piposa/YUDX-tool-changer/README.md

# YUDX-tool-changer
An open source tool changing program for 3D printing.
discord:https://discord.gg/vE4ExaVR3
