piposa/YUDX-tool-changer/“YUDX”BOM.xlsx

 | Info: 1. The finished YUDX extruder kit may be released in the coming months. You may wait for its launch. 2. Amazon links were found by Claude Code. Links may be incorrect, please feedback any errors to me. 3. discord:https://discord.gg/vE4ExaVR3 4. https://github.com/dumplinglab/YUDX-tool-changer
number | Notes | Part Name (corresponds to STEP file) | Qty | Type | Amazon Product | Price | Amazon Link
1 | VORON existing part | MGN12H_block | 1 | Standard Part | MGN12H 300mm Premium Linear Guide Rail 2 Pcs MGN12 Linear Slide 8mm for 3D Printer CNC (2 Pcs/Pack) | $26.92 | https://www.amazon.com/dp/B09ZPHPB5F
2 | VORON existing part | MGN12 | 1 | Standard Part | MGN12H 300mm Premium Linear Guide Rail 2 Pcs MGN12 Linear Slide 8mm for 3D Printer CNC (2 Pcs/Pack) | $26.92 | https://www.amazon.com/dp/B09ZPHPB5F
3 | VORON existing part | Aluminum profiles | 1 | Standard Part |  | $0
4 | Extruder kit | outer_shell_of_extruder | 1 | 3D Printed Part |  | $0
5 | Extruder kit | gear_container_plastic_part | 2 | 3D Printed Part |  | $0
6 | Extruder kit | rack_below_part | 1 | 3D Printed Part |  | $0
7 | Extruder kit | double_layer_gear | 2 | Custom Gear |  | $35
8 | Extruder kit | extrude_gear | 2 | Custom Gear |  | $19.40
9 | Extruder kit | 0.5m10gear | 2 | Custom Gear |  | $32
10 | Extruder kit | gear_container_metal_part | 2 | Custom CNC Part |  | $18.8
11 | Extruder kit | axle_for_extrude_gear | 2 | Custom CNC Part |  | $23
12 | Extruder kit | gear_container_metal_part_mirror | 2 | Custom CNC Part |  | $18.8
13 | Extruder kit | extruder_bottom_metal_part | 1 | Custom CNC Part |  | $9.9
14 | Extruder kit | extruder_top_metal_part | 1 | Custom CNC Part |  | $9.9
15 | Extruder kit | extruder_top_metal_part_mirror | 1 | Custom CNC Part |  | $9.9
16 | Extruder kit | line_cut_rack | 1 | Custom Wire-cut Part |  | $24
17 | Extruder kit | 36_stepper_motor | 1 | Custom Motor |  | $12.82
18 | Extruder kit | screwM3_14 | 2 | Screw |  | $0.50
19 | Extruder kit | one_way_bearing | 2 | Custom Bearing |  | $7.47
20 | Extruder kit | extrude_wheel | 2 | Standard Part | Precise Double Drived Gear Extruder Gear Set for HGX-LITE-extruder Hardened Steel Extruder Driver Gear Set | $10.42 | https://www.amazon.com/gp/product/B0FD3XDJMK
21 | Extruder kit | needle_bearing | 2 | Standard Part | Precise Double Drived Gear Extruder Gear Set for HGX-LITE-extruder Hardened Steel Extruder Driver Gear Set | $0 | https://www.amazon.com/gp/product/B0FD3XDJMK
22 | Extruder kit | 4mm_flange_bearing | 6 | Standard Part | M METERXITY 20pcs MF63ZZ Flange Ball Bearings, 3mm x 6mm x 2.5mm, Dual Metal Seal Chrome Steel (GCr15) | $7.10 | https://www.amazon.com/dp/B0F4XS52R6
23 | Extruder kit | 3mm_flange_bearing | 4 | Standard Part | M METERXITY 20pcs MF63ZZ Flange Ball Bearings, 3mm x 6mm x 2.5mm, Dual Metal Seal Chrome Steel (GCr15) | $7.10 | https://www.amazon.com/dp/B0F4XS52R6
24 | Extruder kit | 4mm_axle | 2 | Standard Part |  | $0.5
25 | Extruder kit | cylinder_pin1.5_5 | 6 | Standard Part | Swpeet 300Pcs 15 Sizes M1 M1.5 304 Stainless Steel Dowel Pin Assortment Kit | $6.72 | https://www.amazon.com/dp/B0G8ZXBGN1
26 | Extruder kit | 4mm_flange_bearing_8mm | 2 | Standard Part | F693ZZ Flange Ball Bearing, ID 3mm x OD 8mm x Width 4mm, Double Metal Shield Deep Groove, Pre-lubricated (GCr15) 10 Pcs | $5.98 | https://www.amazon.com/dp/B0CRLH1WT1
27 | Extruder kit | spring_0.8x7x30 | 1 | Standard Part |  | $2
28 | Extruder kit | 4mm_ball | 32 | Standard Part | 50pcs 4mm 304 Stainless Steel Bearing Balls, 0.15in G200 Precision 28HRC | $4.11 | https://www.amazon.com/dp/B0F2S945ZC
29 | Extruder kit | square_nut | 2 | Standard Part | M3nS Prusa Thin M3 Square Nuts - A2 Stainless Steel DIN 562 (Qty 25) | $5.95 | https://www.amazon.com/dp/B0BD2N9KTV
30 | Extruder kit | mini_door_lock_switch | 16 | Standard Part | 5PCS Door Lock Switch PR-03 Key Switches | $24.68 | https://www.amazon.com/5PCS-Door-Switch-PR-03-Switches/dp/B0H9KGYYP8
31 | Extruder kit | 4.5mm_silicon_sleeve | 7 | Standard Part |  | $5.2
32 |  | Tool_head_front_part | 1 | 3D Printed Part |  | $0
33 |  | Tool_head_back_part | 1 | 3D Printed Part |  | $0
34 |  | voron_connecting_part | 1 | 3D Printed Part |  | $0
35 |  | throat_cooling_fan_seat | 1 | 3D Printed Part |  | $0
36 |  | model_cooling_fan_seat | 1 | 3D Printed Part |  | $0
37 |  | front_cover | 1 | 3D Printed Part |  | $0
38 |  | back_cover | 1 | 3D Printed Part |  | $0
39 |  | tool_head_seat | 7 | 3D Printed Part |  | $0
40 |  | nozzle_cleaning_part | 7 | 3D Printed Part |  | $0
41 |  | air_guide | 7 | 3D Printed Part |  | $0
42 |  | magnet_5-15-3 | 32 | Standard Part | BEST CHOICE Neodymium Magnets 15x3mm, 50pcs Fridge Magnets Rare Earth Magnets for Crafts | $11.21 | https://www.amazon.com/Neodymium-Rectangular-Industrial-Applications-15mmx5mmx4mm/dp/B0GKPBWNSF
43 |  | Bambu_Hotend | 8 | Standard Part | Genuine Bambu Lab Hotend with Nozzle for P1S P1P X1C X1 Carbon 3D Printer .4mm Hardened Steel | $160 | https://www.amazon.com/Genuine-Printer-4mm-Hardened-Steel/dp/B0D2WG7CXQ
44 |  | 2510fan | 1 | Standard Part | 2510 Axial Fan DC 24V, 25x25x10mm Dual Ball Bearing Low Noise Brushless Cooling Fan for 3D Printer Extruder Hotend (2 Pcs) | $11.20 | https://www.amazon.com/dp/B0FR99DQWY
45 |  | 5020fan | 1 | Standard Part | Cooling Case PC Fan 50x50x20mm DC 24V 0.15A 5020 Brushless 2-Pin XH2.54 5500RPM | $4.68 | https://www.amazon.com/dp/B0CWCXGYG1
46 |  | bed_switch | 1 | Standard Part | 20PCS Micro Limit Switch NO+NC Hinge Straight Lever 3PIN 125V 1A Mouse Micro Touch Button Momentary Switch Black | $4.89 | https://www.amazon.com/DAOKAI-Switch-Straight-Button-Momentary/dp/B09WVMRD5V
47 |  | 3010fan | 8 | Standard Part | 3010 Axial Fan DC 24V, 30x30x10mm Hydraulic Bearing Low Noise Silent Brushless Cooling Fan for 3D Printer Extruder Hotend (2 Pcs) | $10.46 | https://www.amazon.com/dp/B0FRFNZFDP
