piposa/YUDX-tool-changer/3Dmodel/YUDX assemble.STEP

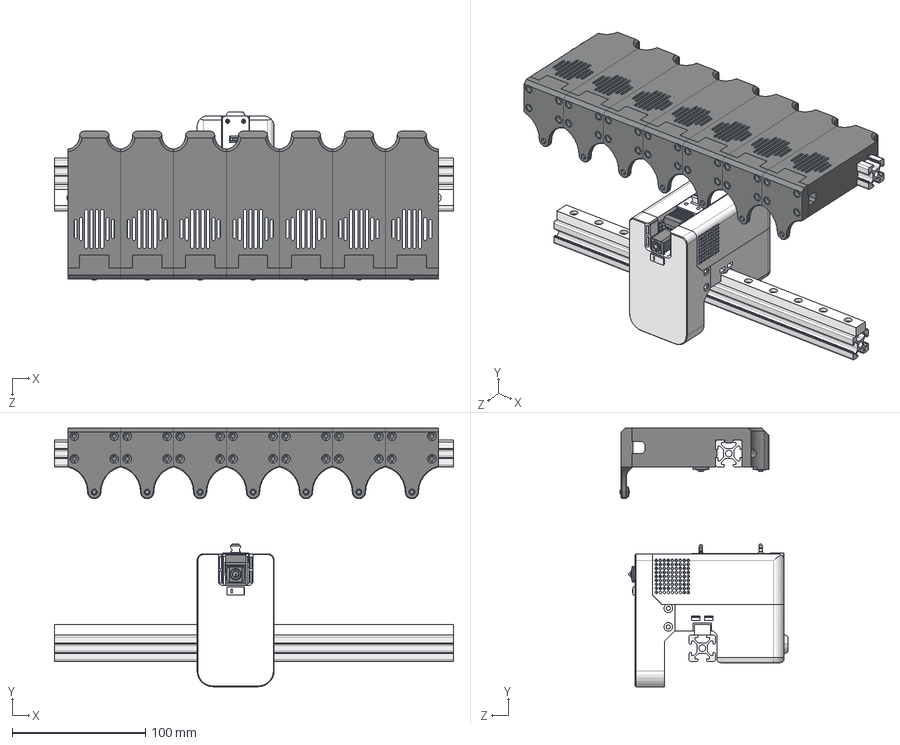
[picture p1: CAD file, 2026-08-13]
3Dmodel/YUDX assemble.STEP
300.0 x 194.4 x 126.4 mm
outer_shell_of_extruder
double_layer_gear
extrude_gear
extrude_wheel
needle_bearing
one_way_bearing
gear_container_metal_part
axle_for_extrude_gear
0.5m10gear
gear_container_plastic_part
gear_container_metal_part_mirror
4mm_flange_bearing x 4
3mm_flange_bearing x 2
4mm_axle
line_cut_rack
rack_below_part
extruder_bottom_metal_part
36_stepper_motor
cylinder_pin1.5_5 x 6
4mm_flange_bearing_8mm x 2
extruder_top_metal_part_mirror
extruder_top_metal_part
magnet_5-15-3 x 8
噩砃double_layer_gear
噩砃extrude_gear
噩砃extrude_wheel
噩砃needle_bearing
噩砃one_way_bearing
噩砃gear_container_metal_part
噩砃axle_for_extrude_gear
噩砃0.5m10gear
噩砃gear_container_plastic_part
噩砃gear_container_metal_part_mirror
噩砃4mm_flange_bearing x 2
噩砃3mm_flange_bearing x 2
噩砃4mm_axle
Tool_head_front_part
Bambu_Hotend1
Bambu_Hotend2
Bambu_Hotend3
Bambu_Hotend4
4mm_ball x 4
Tool_head_back_part
square_nut x 2
screwM3_14 x 2
voron_connecting_part
throat_cooling_fan_seat
2510fan
model_cooling_fan_seat
5020fan
bed_switch
MGN12H_block
MGN12
front_cover
back_cover
tool_head_seat x 7
mini_door_lock_switch x 14
nozzle_cleaning_part x 7
3010fan x 7
air_guide x 7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
