piposa/YUDX-tool-changer/STLs/Tool_head_front_part2.STL

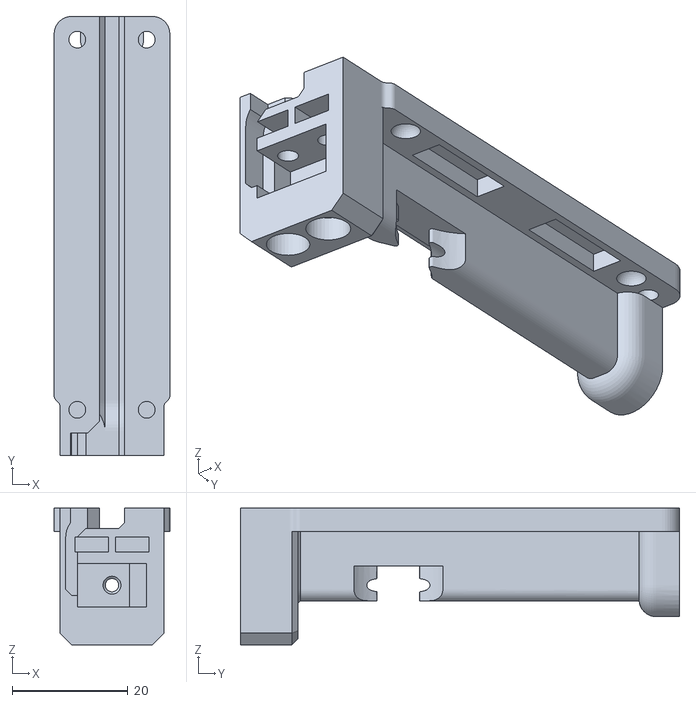
[picture p2: CAD file, 2026-08-25]
STLs/Tool_head_front_part2.STL
20.0 x 75.9 x 23.6
