piposa/YUDX-tool-changer/3Dmodel/YUDX Extruder.STEP

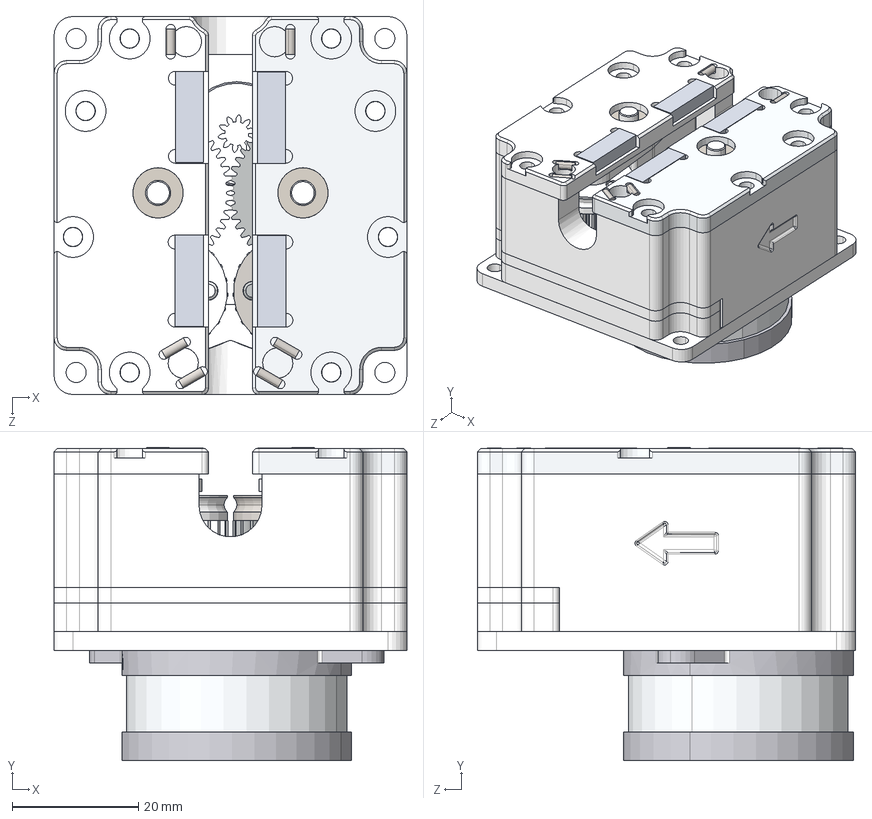
[picture p3: CAD file, 2026-08-13]
3Dmodel/YUDX Extruder.STEP
56.0 x 49.7 x 60.0 mm
outer_shell_of_extruder
double_layer_gear
extrude_gear
extrude_wheel
needle_bearing
one_way_bearing
gear_container_metal_part
axle_for_extrude_gear
0.5m10gear
gear_container_plastic_part
gear_container_metal_part_mirror
4mm_flange_bearing x 4
3mm_flange_bearing x 2
4mm_axle
line_cut_rack
rack_below_part
extruder_bottom_metal_part
36_stepper_motor
cylinder_pin1.5_5 x 6
4mm_flange_bearing_8mm x 2
extruder_top_metal_part_mirror
extruder_top_metal_part
magnet_5-15-3 x 4
噩砃double_layer_gear
噩砃extrude_gear
噩砃extrude_wheel
噩砃needle_bearing
噩砃one_way_bearing
噩砃gear_container_metal_part
噩砃axle_for_extrude_gear
噩砃0.5m10gear
噩砃gear_container_plastic_part
噩砃gear_container_metal_part_mirror
噩砃4mm_flange_bearing x 2
噩砃3mm_flange_bearing x 2
噩砃4mm_axle
