piposa/YUDX-tool-changer/STLs/model_cooling_fan_seat.STL

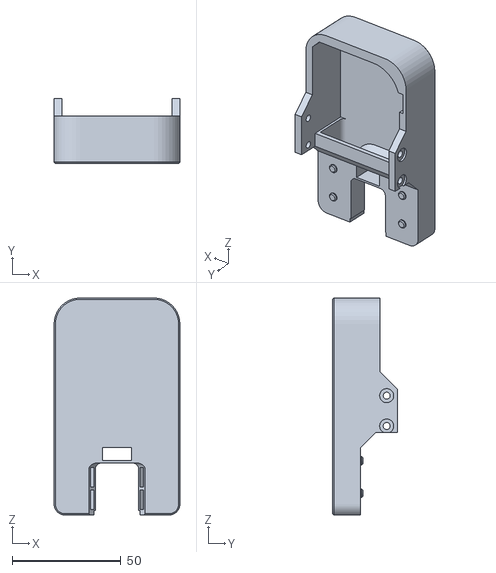
[picture p4: CAD file, 2026-08-13]
STLs/model_cooling_fan_seat.STL
58.0 x 30.0 x 100.0
