piposa/YUDX-tool-changer/3Dmodel/Tool_head_assumption.STEP

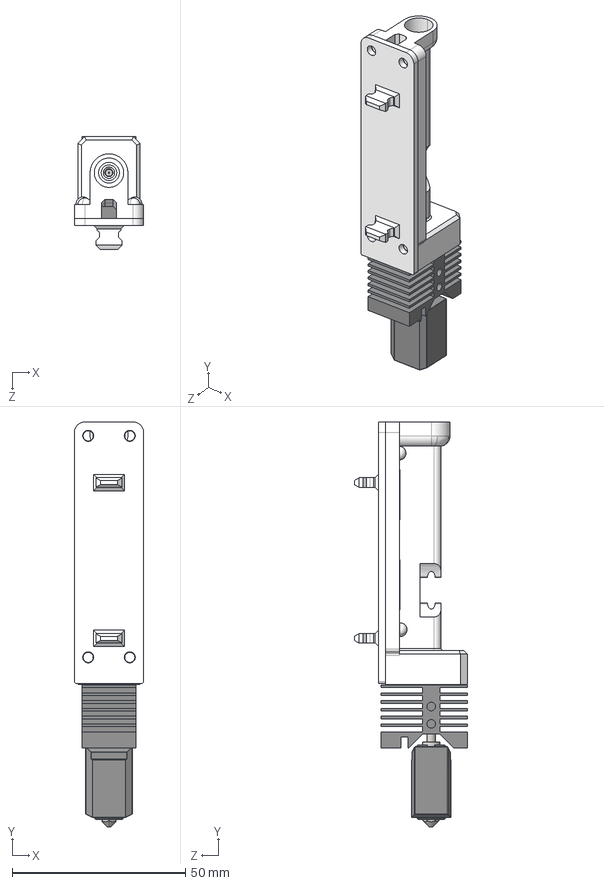
[picture p5: CAD file, 2026-08-13]
3Dmodel/Tool_head_assumption.STEP
20.0 x 117.0 x 32.7 mm
Tool_head_front_part
Bambu_Hotend1
Bambu_Hotend2
Bambu_Hotend3
Bambu_Hotend4
4mm_ball x 4
Tool_head_back_part
magnet_5-15-3 x 4
square_nut x 2
screwM3_14 x 2
