piposa/YUDX-tool-changer/STLs/air_guide.STL

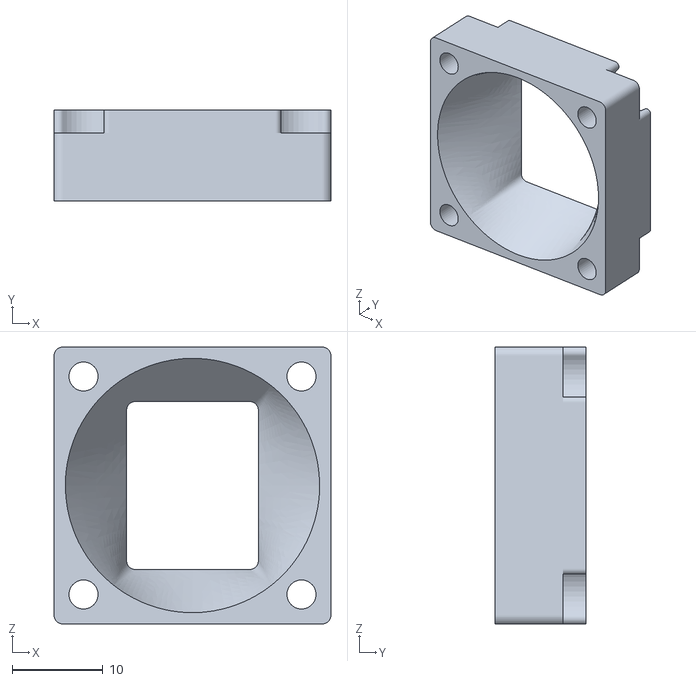
[picture p6: CAD file, 2026-08-13]
STLs/air_guide.STL
30.5 x 10.00 x 30.5
