piposa/YUDX-tool-changer/STLs/nozzle_cleaning_part.STL

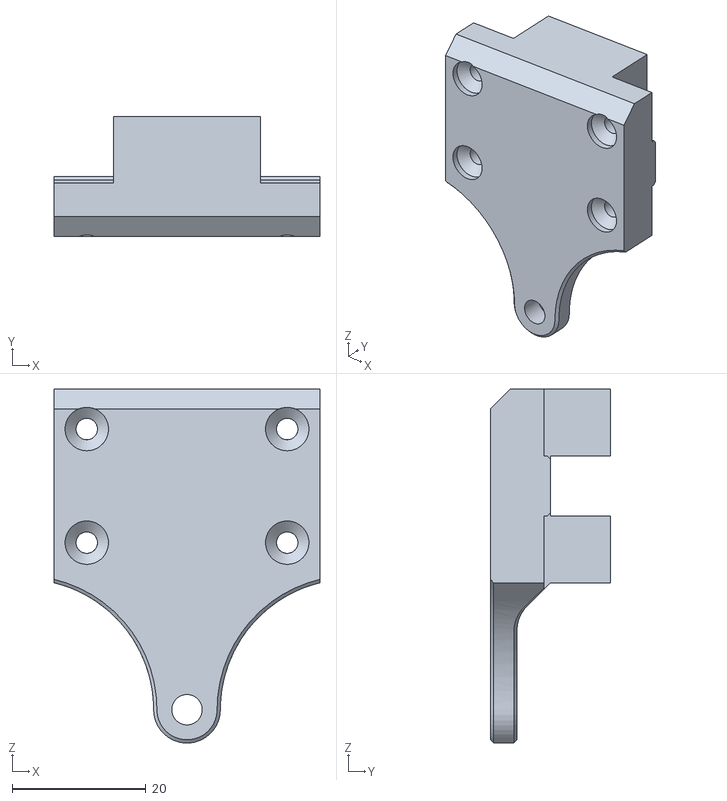
[picture p7: CAD file, 2026-08-13]
STLs/nozzle_cleaning_part.STL
39.8 x 18.0 x 53.0
