piposa/YUDX-tool-changer/STLs/back_cover.STL

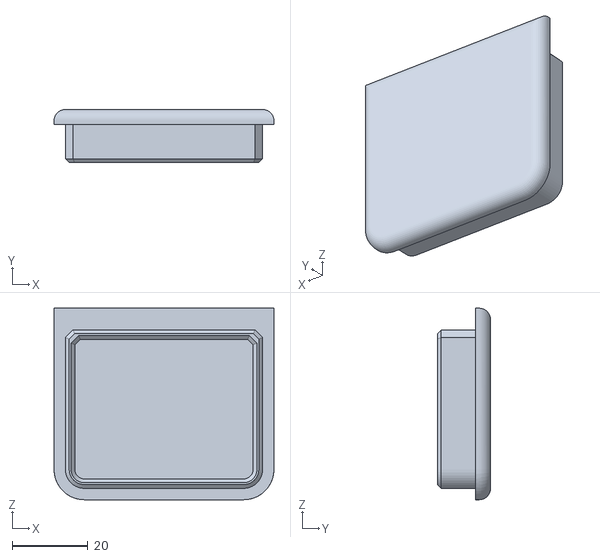
[picture p8: CAD file, 2026-08-13]
STLs/back_cover.STL
58.0 x 14.0 x 50.5
