piposa/YUDX-tool-changer/STLs/front_cover.STL

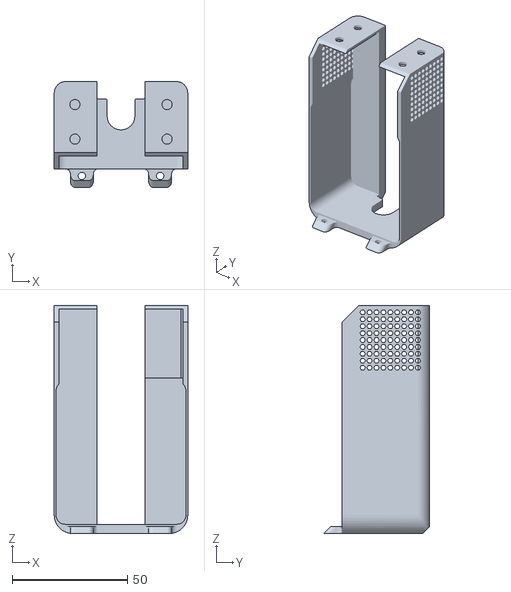
[picture p9: CAD file, 2026-08-13]
STLs/front_cover.STL
58.0 x 46.0 x 99.0
