piposa/YUDX-tool-changer/STLs/Tool_head_back_part.STL

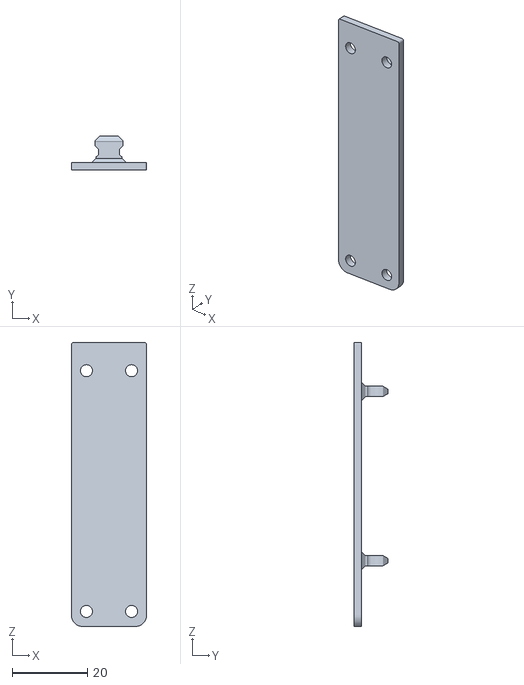
[picture p10: CAD file, 2026-08-13]
STLs/Tool_head_back_part.STL
20.0 x 9.00 x 75.5
