piposa/YUDX-tool-changer/STLs/tool_head_seat.STL

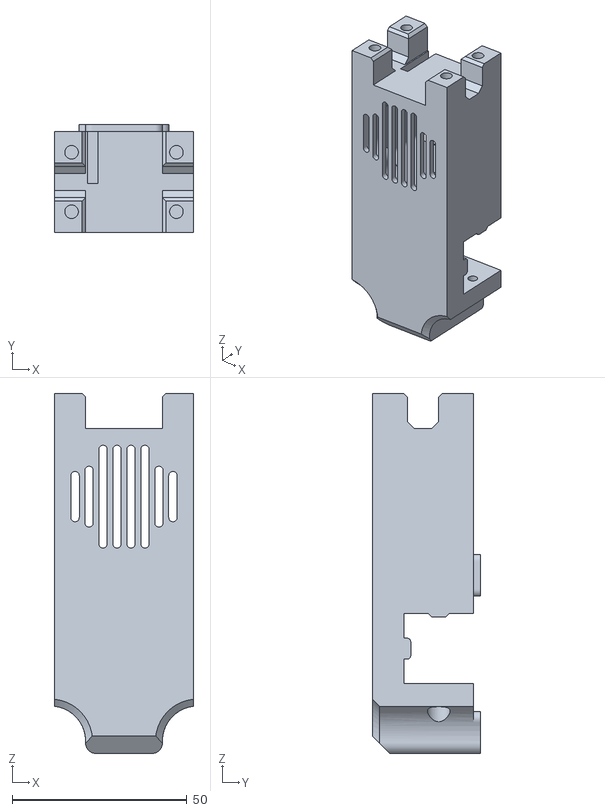
[picture p11: CAD file, 2026-08-13]
STLs/tool_head_seat.STL
39.8 x 31.0 x 103.0
