piposa/YUDX-tool-changer/STLs/throat_cooling_fan_seat.STL

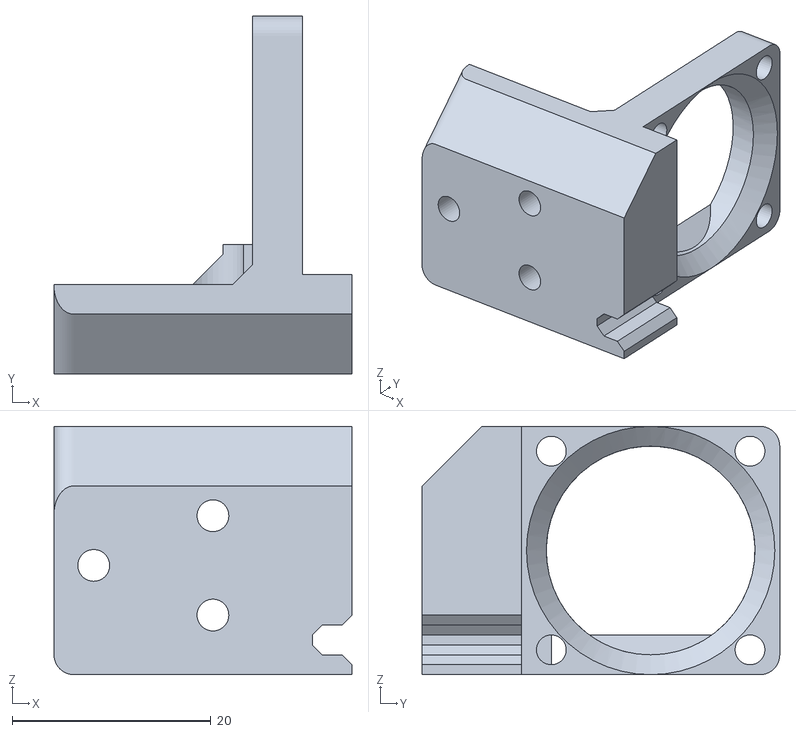
[picture p12: CAD file, 2026-08-13]
STLs/throat_cooling_fan_seat.STL
30.0 x 36.0 x 25.0
