piposa/YUDX-tool-changer/STLs/voron_connecting_part.STL

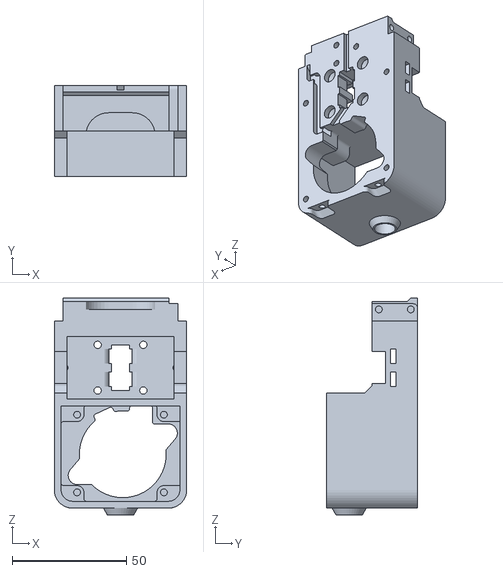
[picture p13: CAD file, 2026-08-13]
STLs/voron_connecting_part.STL
58.0 x 40.0 x 95.0
