piposa/YUDX-tool-changer/(commit log)

2026-08-13 add some files
    [Tool_head_back_part.STL, Tool_head_front_part.STL, air_guide.STL, back_cover.STL, disoffest.g, front_cover.STL, model_cooling_fan_seat.STL, nozzle_cleaning_part.STL]
2026-08-13 add more files
    [Tool_head_assumption.STEP, YUDX Extruder.STEP, YUDX assemble.STEP]
2026-08-13 Add BOM
    [“YUDX”BOM.xlsx]
2026-08-25 A slightly change
    [Tool_head_front_part2.STL]
